mihu-ov/AoA_Sensor/README.md

# AoA_Sensor
Angle of attack sensor based on AMS AS5045 encoder
